hyperion11/Smart-power-supply-khadas-vim/README.md

# Smart-power-supply-khadas-vim
smart power supply for carpc based on khadas vim1 and rtd2662 scaler

IMAGE ALT TEXT HERE (http://www.youtube.com/watch?v=VpjinB8Rm2o)

https://youtu.be/VpjinB8Rm2o
