hyperion11/Smart-power-supply-khadas-vim/powersupply2.png

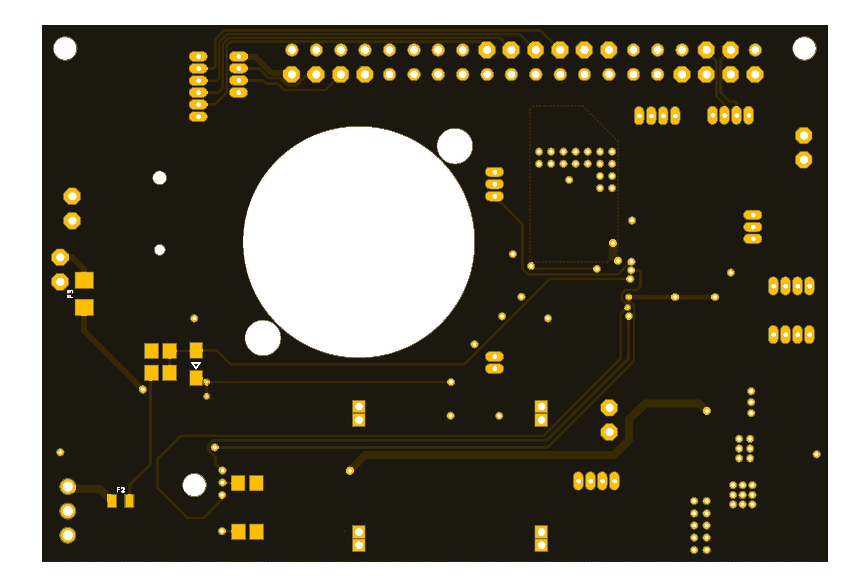
powersupply2.png
