hyperion11/Smart-power-supply-khadas-vim/powersupply.png

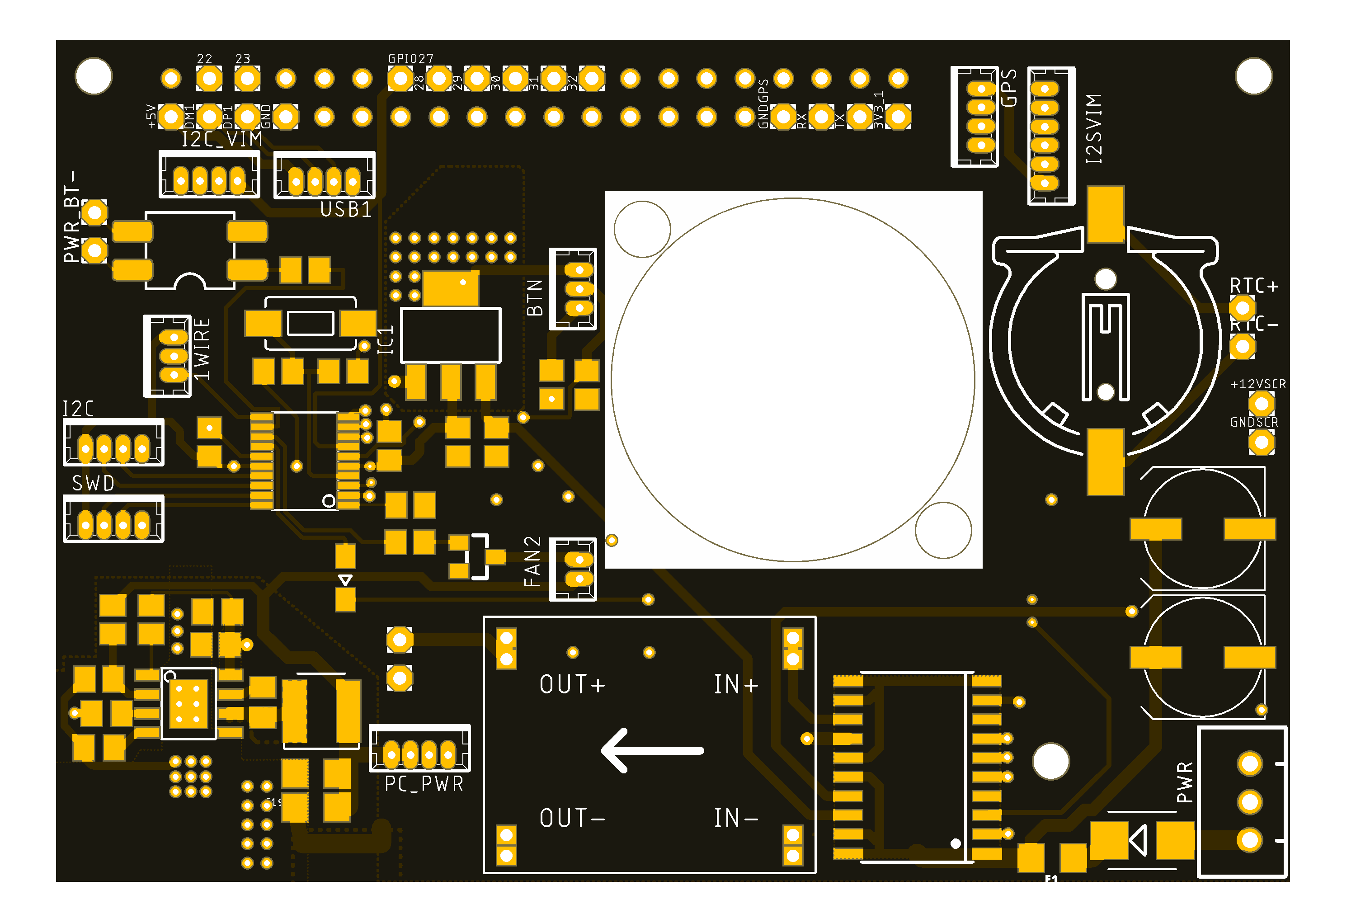
powersupply.png
