hyperion11/Smart-power-supply-khadas-vim/powersupply.xls

Value | Package | MPN | URL
 | 1,6/0,8
 | 1,6/0,8
 | 1,6/0,8
 | 53047-03 | 530470310
 | 1,6/0,8
 | 1,6/0,8
 | 1,6/0,8
 | 1,6/0,8
 | 1,6/0,8
 | 1,6/0,8
 | 1,6/0,8
 | 1,6/0,8
CH291-1220LF | CH291-1220LF
53047-03 | 53047-03 | 530470310
0.1uf | C0805 | CL21B104KBFNNNE
0.1uf | C0805 | CL21B104KBFNNNE
 | UD-8X10_NICHICON
 | UD-8X10_NICHICON
47uF | C1206 | CL31A476MPHNNNE
0.1uf | C0805 | CL21B104KBFNNNE
0.1uf | C0805 | CL21B104KBFNNNE
0.1uf | C0805 | CL21B104KBFNNNE
0.1uF | C0805K | CL21B104KBFNNNE
22uF | C0805 | CL31A226KAHNNNE | https://lcsc.com/product-detail/Multilayer-Ceramic-Capacitors-MLCC-SMD-SMT_SAMSUNG_CL31A226KAHNNNE_22uF-226-10-25V_C12891.html
1uF | C0805K | CL21B105KAFNNNE | https://lcsc.com/product-detail/Multilayer-Ceramic-Capacitors-MLCC-SMD-SMT_Samsung-Electro-Mechanics_CL21B105KAFNNNE_Samsung-Electro-Mechanics-CL21B105KAFNNNE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
8.2nF | C0805K | CL21B822KBANNNC | https://lcsc.com/product-detail/Multilayer-Ceramic-Capacitors-MLCC-SMD-SMT_SAMSUNG_CL21B822KBANNNC_8-2nF-822-10-50V_C170117.html
0.1uF | C0805K | CL21B104KBFNNNE
47uF | C1206 | CL31A476MPHNNNE
 | SMB
 | SOD323-W
 | SOD323-W
 | 1,6/0,8
 | 1,6/0,8
53047-02 | 53047-02 | 53047-0210
 | 1,6/0,8
 | 1,6/0,8
 | 1,6/0,8
 | 1,6/0,8
 | 1,6/0,8
53047-04 | 53047-04 | 53047-0410
i2c | 53047-04 | 53047-0410
53047-04 | 53047-04 | 53047-0410
53047-06 | 53047-06
LM1117MPX-3.3 | SOT223
BTS716G | PG-DSO-20
STM32F030F4P | TSSOP20-I
BCIHP0730-3R3M | VLS4045EX | VLS5045EX-3R3N | https://lcsc.com/product-detail/Power-Inductors_TDK_VLS5045EX-3R3N_TDK-VLS5045EX-3R3N_C307875.html
PC817SMD | DIL04SMD
i2c | 53047-04 | 53047-0410
JST-XH-03-PIN-LONG-PAD | JST-XH-03-PACKAGE-LONG-PAD
 | 1,6/0,8
 | 1,6/0,8
BSS138 | SOT23
150 | R0805
150 | R0805
10k | R0805
2.2k | R0805
10k | R0805
10k | R0805
10K | M0805
10K | M0805
10K | M0805
150 | R0805
22.1K | M0805 | TR0805B22K1P0525Z
124K | M0805 | AR05BTCW1253
10k | M0805
 | 1,6/0,8
 | 1,6/0,8
 | 1,6/0,8
 | TACTILE-SWITCH-1101NE
53047-04 | 53047-04 | 53047-0410
 | 1,6/0,8
MP1584 | DC-BRICK
TPS54428 | PDSO-8 | TPS54428DDAR | https://lcsc.com/product-detail/DC-DC-Converters_Texas-Instruments_TPS54428DDAR_Texas-Instruments-Texas-Instruments-TPS54428DDAR_C138717.html
53047-04 | 53047-04 | 53047-0410
