hyperion11/Smart-power-supply-khadas-vim/powersupply.brd

## EAGLE design powersupply.brd (2020-01-21)

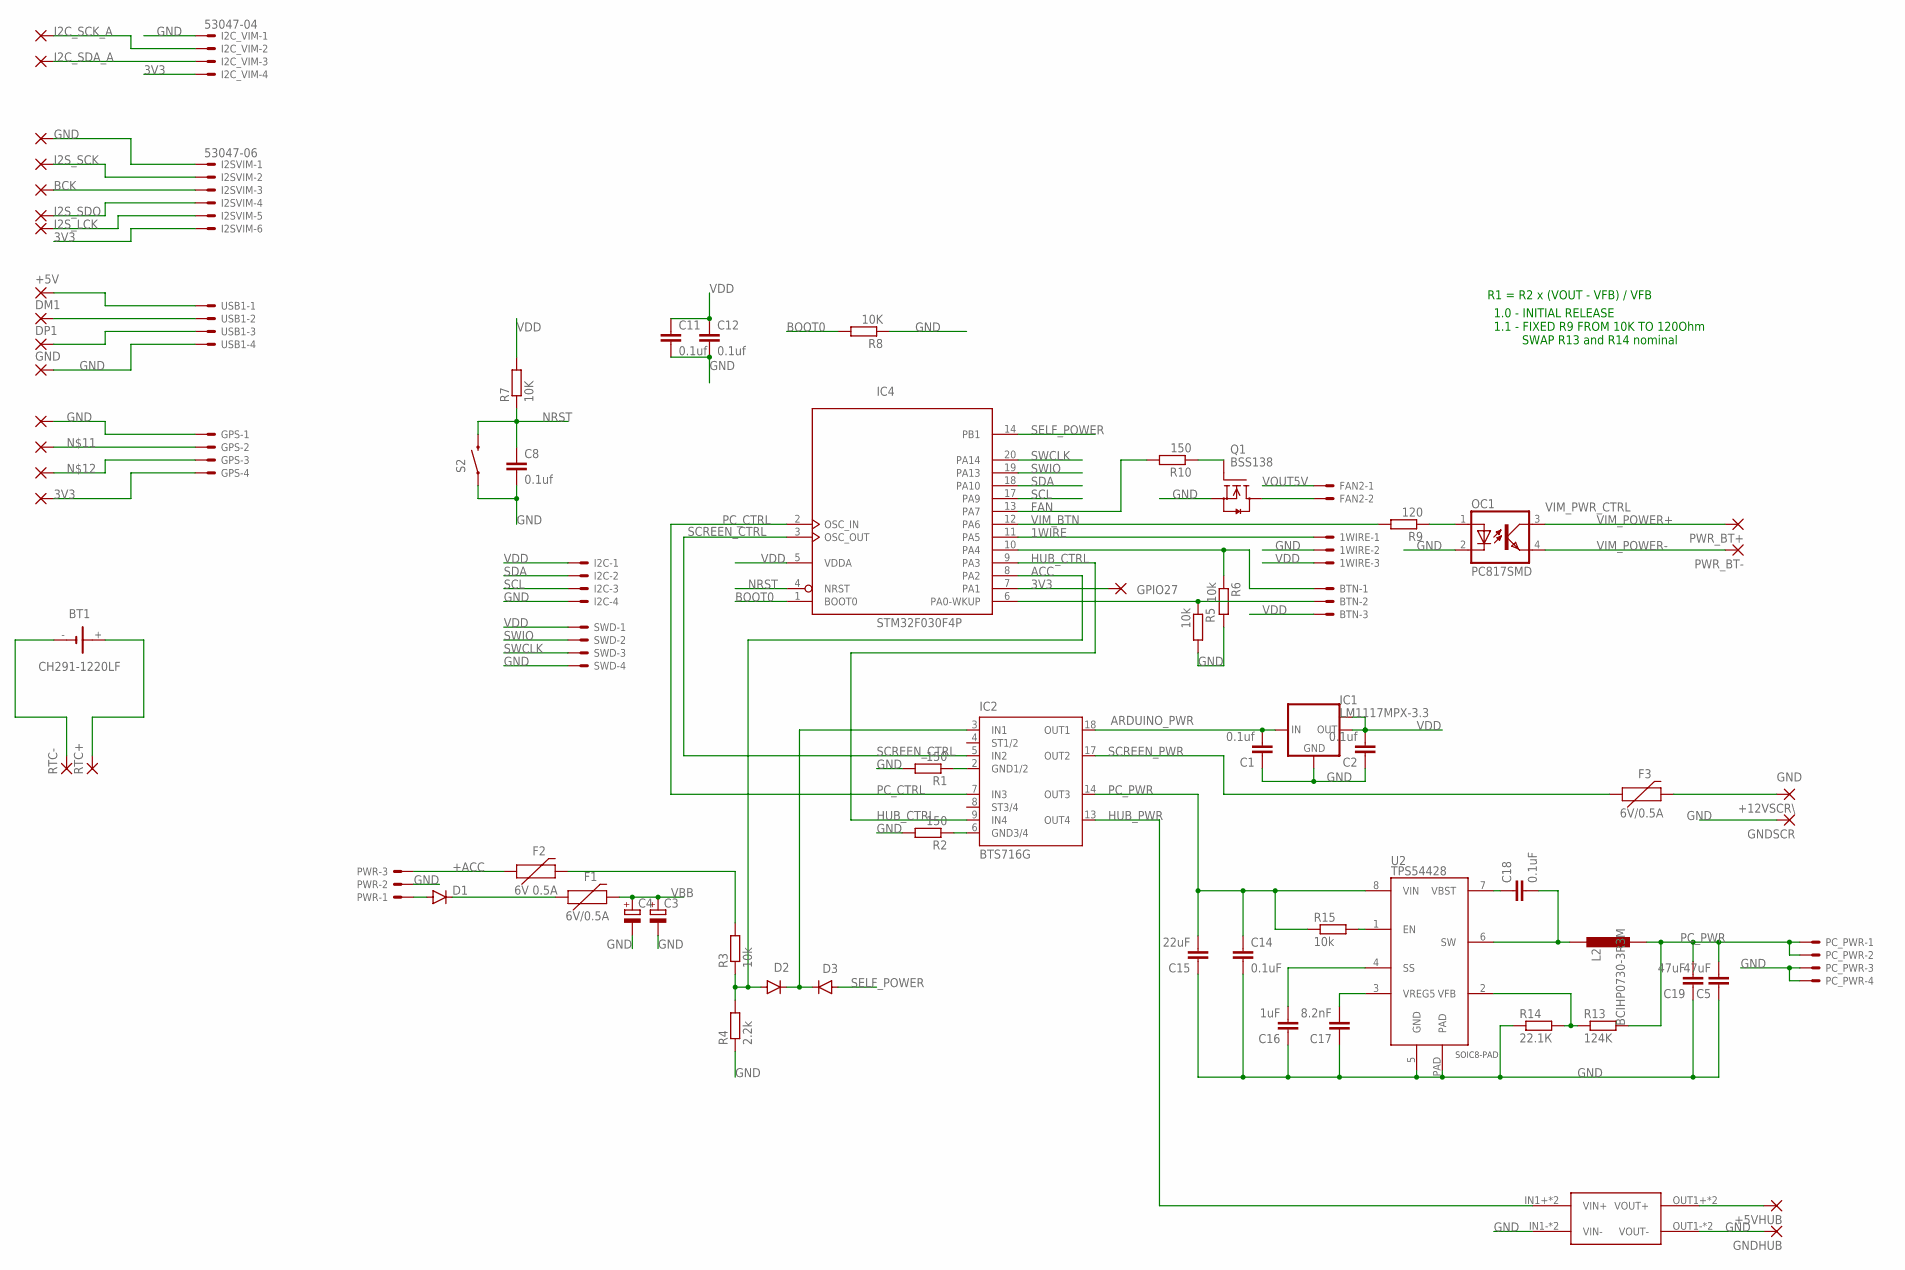
[picture p3: schematic powersupply.sch]

Parts:
1WIRE: 53047-03
3V3_1, 22, 23, 28, 29, 30, 31, 32: 1,6/0,8
+5V, +5VHUB, +12VSCR\: 1,6/0,8
BT1: CH291-1220LF
BTN: 53047-03
C1, C2, C8, C11, C12: 0.1uf; C0805; MPN CL21B104KBFNNNE
C3, C4: CPOL-EUUD-8X10; UD-8X10_NICHICON
C5, C19: 47uF; C1206; MPN CL31A476MPHNNNE
C14, C18: 0.1uF; C0805K; MPN CL21B104KBFNNNE
C15: 22uF; C0805; MPN CL31A226KAHNNNE
C16: 1uF; C0805K; MPN CL21B105KAFNNNE
C17: 8.2nF; C0805K; MPN CL21B822KBANNNC
D1: DIODE-SMB; SMB
D2, D3: DIODE-SOD323-W; SOD323-W
DM1: 1,6/0,8
DP1: 1,6/0,8
F1, F3: 6V/0.5A; 1206
F2: 6V 0.5A; 0805
FAN2: 53047-02
GND: 1,6/0,8
GNDGPS: 1,6/0,8
GNDHUB: 1,6/0,8
GNDSCR: 1,6/0,8
GPIO27: 1,6/0,8
GPS: 53047-04
I2C: i2c; 53047-04
I2C_VIM: 53047-04
I2SVIM: 53047-06
IC1: LM1117MPX-3.3; SOT223; MPN LM1117IMPX-3.3/NOPB
IC2: BTS716G; PG-DSO-20
IC4: STM32F030F4P; TSSOP20-I
L2: BCIHP0730-3R3M; VLS4045EX; MPN VLS5045EX-3R3N
OC1: PC817SMD; DIL04SMD; MPN PC817X2CSP9F
PC_PWR: i2c; 53047-04
PWR: JST-XH-03-PIN-ROUND-PAD; JST-XH-03-PACKAGE-ROUND-PAD
PWR_BT+: 1,6/0,8
PWR_BT-: 1,6/0,8
Q1: BSS138; SOT23
R1, R2, R10: 150; R0805
R3, R5, R6: 10k; R0805
R4: 2.2k; R0805
R7, R8: 10K; M0805
R9: 120; M0805
R13: 124K; M0805; MPN TR0805B22K1P0525Z
R14: 22.1К; M0805; MPN AR05BTCW1253
R15: 10k; M0805
RTC+: 1,6/0,8
RTC-: 1,6/0,8
RX: 1,6/0,8
S2: SWITCH-MOMENTARY-2-SMD-1101NE; TACTILE-SWITCH-1101NE
SWD: 53047-04
TX: 1,6/0,8
U2: TPS54428; PDSO-8
U$1: MP1584; DC-BRICK
USB1: 53047-04

Connections:
1WIRE: 1WIRE.1, IC4.11 (PA5)
3V3: 3V3_1.1, GPIO27.1, GPS.4, I2C_VIM.4, I2SVIM.6, IC4.7 (PA1)
+ACC: F2.2, R3.2
ACC: D2.A, IC4.8 (PA2), R3.1, R4.2
ARDUINO_PWR: C1.2, IC1.3 (IN), IC2.18 (OUT1)
BCK: 30.1, I2SVIM.3
BOOT0: IC4.1 (BOOT0), R8.2
FAN: IC4.13 (PA7), R10.2
GND: 1WIRE.2, 28.1, C1.1, C2.1, C3.-, C4.-, C5.1, C8.2, C11.2, C12.2, C14.2, C15.1, C16.1, C17.1, C19.1, GND.1, GNDGPS.1, GNDHUB.1, GNDSCR.1, GPS.1, I2C.4, I2C_VIM.1, I2SVIM.1, IC1.1 (GND), IC4.15 (GND), OC1.2 (C), PC_PWR.3, PC_PWR.4, PWR.2, Q1.2 (S), R1.2, R2.2, R4.1, R5.2, R6.2, R8.1, R14.1, S2.P$1 (1), SWD.4, U2.5 (GND), U2.PAD, U$1.IN1- (VIN-), U$1.IN2- (VIN-), U$1.OUT1- (VOUT-), U$1.OUT2- (VOUT-), USB1.4
HUB_CTRL: IC2.9 (IN4), IC4.9 (PA3)
HUB_PWR: IC2.13 (OUT4), U$1.IN1+ (VIN+), U$1.IN2+ (VIN+)
I2C_SCK_A: 22.1, I2C_VIM.2
I2C_SDA_A: 23.1, I2C_VIM.3
I2S_LCK: 32.1, I2SVIM.5
I2S_SCK: 29.1, I2SVIM.2
I2S_SDO: 31.1, I2SVIM.4
unnamed: IC2.2 (GND1/2), R1.1
unnamed: +5V.1, USB1.1
unnamed: FAN2.2, Q1.3 (D)
unnamed: D2.C, D3.C, IC2.3 (IN1)
unnamed: IC2.6 (GND3/4), R2.1
unnamed: BTN.1, IC4.10 (PA4), R6.1
unnamed: DM1.1, USB1.2
unnamed: DP1.1, USB1.3
unnamed: Q1.1 (G), R10.1
unnamed: BT1.-, RTC-.1
unnamed: GPS.2, RX.1
unnamed: GPS.3, TX.1
unnamed: BTN.2, IC4.6 (PA0-WKUP), R5.1
unnamed: F2.1, PWR.3
unnamed: BT1.+, RTC+.1
unnamed: D1.A, PWR.1
unnamed: +5VHUB.1, U$1.OUT1+ (VOUT+), U$1.OUT2+ (VOUT+)
unnamed: D1.C, F1.1
unnamed: +12VSCR\.1, F3.2
unnamed: C16.2, U2.4 (SS)
unnamed: C17.2, U2.3 (VREG5)
unnamed: C18.1, U2.7 (VBST)
unnamed: C18.2, L2.1, U2.6 (SW)
unnamed: R13.1, R14.2, U2.2 (VFB)
unnamed: R15.2, U2.1 (EN)
NRST: C8.1, IC4.4 (NRST), R7.1, S2.P$2 (2)
PC_CTRL: IC2.7 (IN3), IC4.2 (OSC_IN)
PC_PWR: C14.1, C15.2, IC2.14 (OUT3), R15.1, U2.8 (VIN)
SCL: I2C.3, IC4.17 (PA9)
SCREEN_CTRL: IC2.5 (IN2), IC4.3 (OSC_OUT)
SCREEN_PWR: F3.1, IC2.17 (OUT2)
SDA: I2C.2, IC4.18 (PA10)
SELF_POWER: D3.A, IC4.14 (PB1)
SWCLK: IC4.20 (PA14), SWD.3
SWIO: IC4.19 (PA13), SWD.2
VBB: C3.+, C4.+, F1.2, IC2.1 (VBB), IC2.10 (VBB), IC2.11 (VBB), IC2.12 (VBB), IC2.15 (VBB), IC2.16 (VBB), IC2.19 (VBB), IC2.20 (VBB)
VDD: 1WIRE.3, BTN.3, C2.2, C11.1, C12.1, I2C.1, IC1.2 (OUT), IC1.TAB (OUT1), IC4.5 (VDDA), IC4.16 (VDD), R7.2, SWD.1
VIM_BTN: IC4.12 (PA6), R9.2
VIM_POWER+: OC1.3 (COL), PWR_BT+.1
VIM_POWER-: OC1.4 (EMIT), PWR_BT-.1
VIM_PWR_CTRL: OC1.1 (A), R9.1
VOUT5V: C5.2, C19.2, FAN2.1, L2.2, PC_PWR.1, PC_PWR.2, R13.2

Notes on the sheet:
R1 = R2 x (VOUT - VFB) / VFB
1.0 - INITIAL RELEASE 1.1 - FIXED R9 FROM 10K TO 120Ohm SWAP R13 and R14 nominal

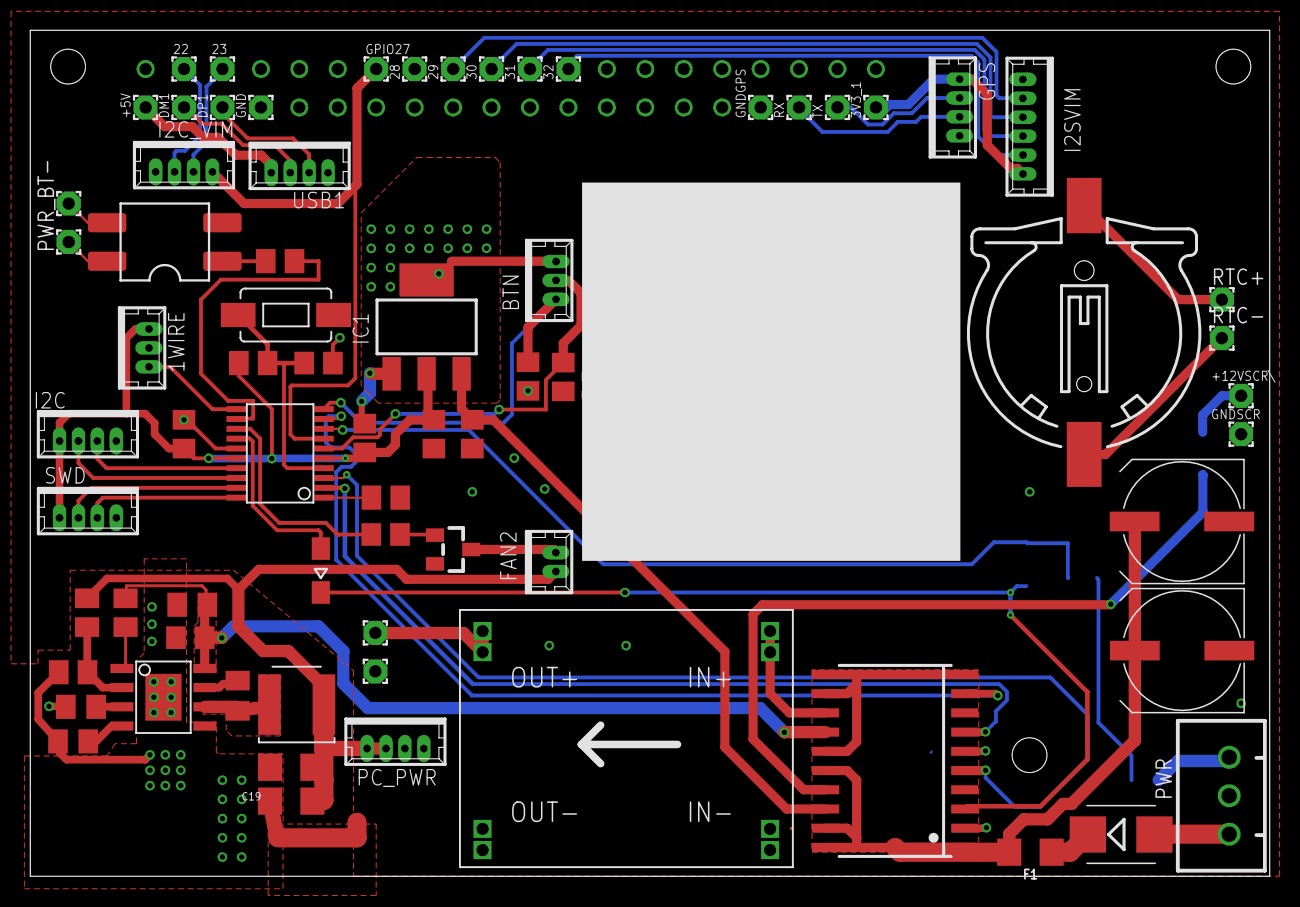
[picture p4: board powersupply.brd from above]

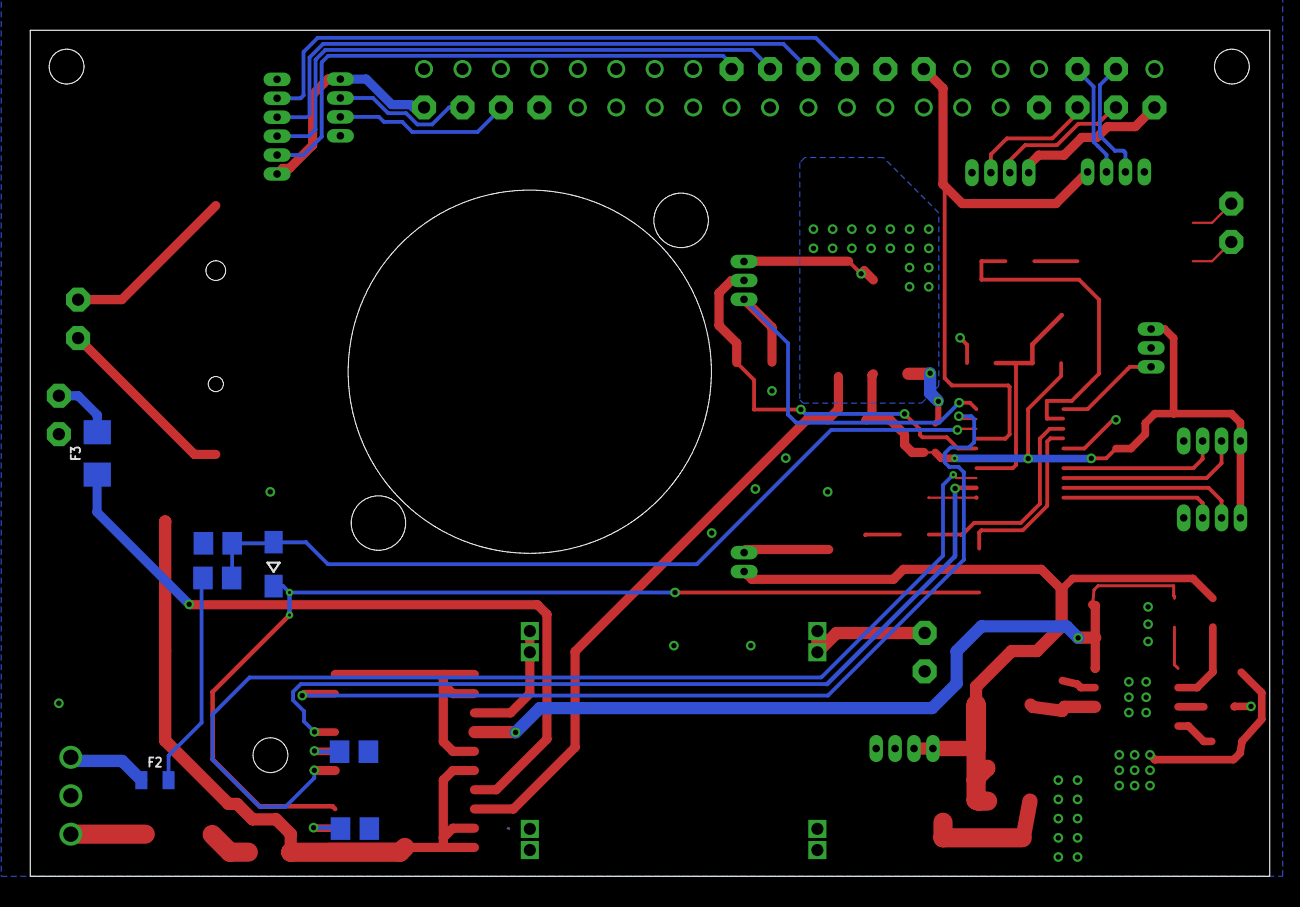
[picture p5: board powersupply.brd from below]

Board: 2 copper layers, 81.9 x 55.9 mm, 78 parts (7 on the bottom side), 58 nets.
