hyperion11/Smart-power-supply-khadas-vim/firmware/Src/main.c

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

/* Includes ------------------------------------------------------------------*/
#include "main.h"

/* USER CODE BEGIN Includes */
#include "arm_math.h"
#include "stdlib.h"
#include <stdbool.h>
#include "ssd1306.h"
#include "fonts.h"
/* USER CODE END Includes */

/* USER CODE BEGIN PTD */
const uint8_t SUSPEND_TIME=10;
const uint8_t SHUTDOWN_TIME=30;
const uint16_t SHUTDOWN_KEYPRESS_TIME=1000; //milliseconds
const uint16_t SHUTDOWN_CHECK_INTERVAL=20; //seconds
const uint8_t VIM_START_DELAY=10; //seconds
/* USER CODE END PTD */

ADC_HandleTypeDef hadc;

/* USER CODE BEGIN PV */


struct screen_str {
	bool enabled;
};

struct acc_str {
	bool enabled;
	bool low;
	uint16_t voltage;
	uint32_t time_to_suspend;
	uint32_t time_to_shutdown;
};

struct vim_str {
	bool enabled;
	bool sleep;
	bool voltage;
	uint8_t shutdown_count;
};

struct itps_str {
	bool enabled;
	uint32_t time_to_action;
};

struct hub_str {
	bool enabled;
};
struct screen_str SCREEN;
struct vim_str VIM;
struct itps_str ITPS;
struct hub_str HUB;
struct acc_str ACC;

uint32_t now, next;
float t;
/* USER CODE END PV */

void SystemClock_Config(void);
static void MX_GPIO_Init(void);
static void MX_ADC_Init(void);
/* USER CODE BEGIN 0 */
uint16_t readADC() {
	uint16_t adc = 0;
	HAL_ADC_Start(&hadc);
	if (HAL_ADC_PollForConversion(&hadc, 100) != HAL_OK) {
		Error_Handler();
	} else {
		adc = HAL_ADC_GetValue(&hadc);
	}
	HAL_ADC_Stop(&hadc);
	return adc;
}

bool checkVIM() {
	VIM.voltage = HAL_GPIO_ReadPin(GPIOA, GPIO_PIN_1);
	if (VIM.voltage == true)
		return 1;
	else
		return 0;
}

void EnableScreen(bool force) {
	if (SCREEN.enabled == false) {
		HAL_GPIO_WritePin(SCREEN_PWR_GPIO_Port, SCREEN_PWR_Pin, GPIO_PIN_SET);
		SCREEN.enabled = true;
	}
	if (force) {
		HAL_GPIO_WritePin(SCREEN_PWR_GPIO_Port, SCREEN_PWR_Pin, GPIO_PIN_SET);
		SCREEN.enabled = true;
	}
}

void EnableVIM(bool force) {
	if (VIM.enabled == false) {
		HAL_GPIO_WritePin(FAN_GPIO_Port, FAN_Pin, GPIO_PIN_SET);
		HAL_GPIO_WritePin(PC_PWR_GPIO_Port, PC_PWR_Pin, GPIO_PIN_SET);
		VIM.enabled = true;
	}
	if (force) {
		HAL_GPIO_WritePin(PC_PWR_GPIO_Port, PC_PWR_Pin, GPIO_PIN_SET);
		HAL_GPIO_WritePin(FAN_GPIO_Port, FAN_Pin, GPIO_PIN_SET);
		VIM.enabled = true;
	}
}

void EnableHUB(bool force) {
	if (HUB.enabled == false) {
		HAL_GPIO_WritePin(HUB_PWR_GPIO_Port, HUB_PWR_Pin, GPIO_PIN_SET);
		HUB.enabled = true;
	}
	if (force) {
		HAL_GPIO_WritePin(HUB_PWR_GPIO_Port, HUB_PWR_Pin, GPIO_PIN_SET);
		HUB.enabled = true;
	}
}

void DisableScreen(bool force) {
	if (SCREEN.enabled == true) {
		HAL_GPIO_WritePin(SCREEN_PWR_GPIO_Port, SCREEN_PWR_Pin, GPIO_PIN_RESET);
		SCREEN.enabled = false;
	}
	if (force) {
		HAL_GPIO_WritePin(SCREEN_PWR_GPIO_Port, SCREEN_PWR_Pin, GPIO_PIN_RESET);
		SCREEN.enabled = false;
	}
}

void DisableVIM(bool force) {
	if (VIM.enabled == true) {
		HAL_GPIO_WritePin(FAN_GPIO_Port, FAN_Pin, GPIO_PIN_RESET);
		HAL_GPIO_WritePin(PC_PWR_GPIO_Port, PC_PWR_Pin, GPIO_PIN_RESET);
		VIM.enabled = false;
		VIM.sleep = false;
	}
	if (force) {
		HAL_GPIO_WritePin(FAN_GPIO_Port, FAN_Pin, GPIO_PIN_RESET);
		HAL_GPIO_WritePin(PC_PWR_GPIO_Port, PC_PWR_Pin, GPIO_PIN_RESET);
		VIM.enabled = false;
		VIM.sleep = false;
	}
}

void DisableHUB(bool force) {
	if (HUB.enabled == true) {
		HAL_GPIO_WritePin(HUB_PWR_GPIO_Port, HUB_PWR_Pin, GPIO_PIN_RESET);
		HUB.enabled = false;
	}
	if (force) {
		HAL_GPIO_WritePin(HUB_PWR_GPIO_Port, HUB_PWR_Pin, GPIO_PIN_RESET);
		HUB.enabled = false;
	}
}

void DisableITPS() {
	HAL_GPIO_WritePin(SELF_PWR_GPIO_Port, SELF_PWR_Pin, GPIO_PIN_RESET);
	ITPS.enabled = false;
}

void SuspendVIM() {
	if (VIM.sleep == false) {
		HAL_GPIO_WritePin(VIM_BTN_GPIO_Port, VIM_BTN_Pin, GPIO_PIN_SET);
		HAL_Delay(100);
		HAL_GPIO_WritePin(VIM_BTN_GPIO_Port, VIM_BTN_Pin, GPIO_PIN_RESET);
		HAL_GPIO_WritePin(FAN_GPIO_Port, FAN_Pin, GPIO_PIN_RESET);
		VIM.sleep = true;
	}
}

void ShutdownVIM() {
	HAL_GPIO_WritePin(VIM_BTN_GPIO_Port, VIM_BTN_Pin, GPIO_PIN_SET);
	HAL_Delay(SHUTDOWN_KEYPRESS_TIME);
	HAL_GPIO_WritePin(VIM_BTN_GPIO_Port, VIM_BTN_Pin, GPIO_PIN_RESET);
}

void ResumeVIM() {
	if (VIM.sleep == true) {
		HAL_GPIO_WritePin(VIM_BTN_GPIO_Port, VIM_BTN_Pin, GPIO_PIN_SET);
		HAL_Delay(500);
		HAL_GPIO_WritePin(VIM_BTN_GPIO_Port, VIM_BTN_Pin, GPIO_PIN_RESET);
		VIM.sleep = false;
		HAL_GPIO_WritePin(FAN_GPIO_Port, FAN_Pin, GPIO_PIN_SET);
	}
}

long map(long x, long in_min, long in_max, long out_min, long out_max) {
	return (x - in_min) * (out_max - out_min) / (in_max - in_min) + out_min;
}

/* USER CODE END 0 */

/**
  * @brief  The application entry point.
  * @retval int
  */
int main(void)
{
  /* MCU Configuration--------------------------------------------------------*/

  /* Reset of all peripherals, Initializes the Flash interface and the Systick. */
  HAL_Init();

  /* Configure the system clock */
  SystemClock_Config();

  /* Initialize all configured peripherals */
  MX_GPIO_Init();
  MX_ADC_Init();
  /* USER CODE BEGIN 2 */
  	  RCC->APB2ENR |= RCC_APB2ENR_TIM16EN; //тактируем таймер
  	  TIM16->CR1 |= TIM_CR1_CEN; //включаем
	HAL_ADC_Stop(&hadc);
	HAL_ADCEx_Calibration_Start(&hadc);
  /* USER CODE END 2 */

  /* Infinite loop */
  /* USER CODE BEGIN WHILE */
	VIM.shutdown_count=0;
	HAL_GPIO_WritePin(SELF_PWR_GPIO_Port, SELF_PWR_Pin, GPIO_PIN_SET);
	ITPS.enabled = true;
	HUB.enabled = false;
	SCREEN.enabled = false;
	VIM.enabled = false;
	VIM.sleep = false;
	HAL_Delay(2000);
	while (readADC() < 2814) {
	}
	EnableScreen(false);
	HAL_Delay(VIM_START_DELAY*1000);
	if (readADC() >2814)
		EnableVIM(false);
	else
		DisableITPS();		//disable WHOLE Supply voltage
	HAL_Delay(2000);
	EnableHUB(false);
	while (1) {
		ACC.voltage = readADC();
		//every 100ms
		if (HAL_GetTick() >= next) {
			ACC.voltage = readADC();
			checkVIM();
			if (ACC.voltage < 3169 && ACC.time_to_suspend == 0 && ACC.time_to_shutdown == 0) //ACC Voltage below 11v
			{
				if (VIM.enabled==false)
				{
					DisableVIM(false);	//disable VIM Supply voltage
					HAL_Delay(10);
					DisableHUB(false);	//disable HUB Supply voltage
					HAL_Delay(10);
					DisableScreen(false);
					HAL_Delay(100);	//disable SCREEN Supply voltage
					DisableITPS();		//disable WHOLE Supply voltage
				}
				else
				{
					ACC.enabled = false;
					ACC.low = true;
					ACC.time_to_suspend = HAL_GetTick() + SUSPEND_TIME * 1000; //10 seconds to suspend
					ACC.time_to_shutdown = ACC.time_to_suspend + SHUTDOWN_TIME * 1000; //5 hours to shutdown
				}
			}
			if (ACC.voltage > 3169) //if ACC voltage > 12.2V! cancel suspend an resume carpc
					{
				ACC.enabled = true;
				ACC.low = false;
				ACC.time_to_suspend = 0; //
				ACC.time_to_shutdown = 0; //
			}
			next = HAL_GetTick() + 100;
		}
		if (HAL_GetTick() >= ACC.time_to_suspend && ACC.time_to_suspend != 0) {
			SuspendVIM(false);
			HAL_Delay(5000); // 5 seconds to suspend
			DisableHUB(false);
			HAL_Delay(2000);
			DisableScreen(false);
		}
		if (HAL_GetTick() >= ACC.time_to_shutdown && ACC.time_to_shutdown != 0) {
			EnableScreen(false);
			HAL_Delay(2 * 1000);
			ShutdownVIM();  //VIM starts to resume from sleep
			HAL_Delay(5 * 1000); //5 seconds to resuming
			while (checkVIM()) { // checking voltage on GPIO27 VIM's pin.
				ShutdownVIM();	// if still HIGH try shutdown again
				HAL_Delay(SHUTDOWN_CHECK_INTERVAL * 1000); //~20 seconds to shutdown OS on vim
				VIM.shutdown_count++;	//counter of shutdown tries
				if (VIM.shutdown_count>5) // maximum 4 retries
				{
					DisableVIM(false); 		//and hard off
					break;
				}
			}
			HAL_Delay(2 * 1000);
			DisableVIM(false);	//disable VIM Supply voltage
			HAL_Delay(2 * 1000);
			DisableHUB(false);	//disable HUB Supply voltage
			HAL_Delay(1000);
			DisableScreen(false);
			HAL_Delay(1000);	//disable SCREEN Supply voltage
			DisableITPS();		//disable WHOLE Supply voltage
		}
		if (ACC.time_to_suspend == 0 && VIM.sleep == true) {
			EnableScreen(false);
			HAL_Delay(2 * 1000);
			ResumeVIM(false);
			HAL_Delay(4 * 1000); //4 seconds to resume
			EnableHUB(false);
		}
		if (ACC.time_to_shutdown == 0 && VIM.enabled == false) {
			EnableScreen(false);
			HAL_Delay(2 * 1000);
			EnableVIM(false);
			HAL_Delay(2 * 1000);
			EnableHUB(false);
		}

    /* USER CODE END WHILE */

    /* USER CODE BEGIN 3 */
	}
  /* USER CODE END 3 */
}

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
