hyperion11/Smart-power-supply-khadas-vim/firmware/Inc/main.h

#define PC_PWR_Pin GPIO_PIN_0
#define PC_PWR_GPIO_Port GPIOF
#define SCREEN_PWR_Pin GPIO_PIN_1
#define SCREEN_PWR_GPIO_Port GPIOF
#define BTN2_Pin GPIO_PIN_0
#define BTN2_GPIO_Port GPIOA
#define VIM_IN_Pin GPIO_PIN_1
#define VIM_IN_GPIO_Port GPIOA
#define HUB_PWR_Pin GPIO_PIN_3
#define HUB_PWR_GPIO_Port GPIOA
#define BTN1_Pin GPIO_PIN_4
#define BTN1_GPIO_Port GPIOA
#define VIM_BTN_Pin GPIO_PIN_6
#define VIM_BTN_GPIO_Port GPIOA
#define FAN_Pin GPIO_PIN_7
#define FAN_GPIO_Port GPIOA
#define SELF_PWR_Pin GPIO_PIN_1
#define SELF_PWR_GPIO_Port GPIOB
