hyperion11/Smart-power-supply-khadas-vim/(commit log)

2019-08-02 init commit
    [powersupply.brd, powersupply.sch]
2020-01-21 фиксы схемы
    R9 FROM 10K TO 120Ohm
    SWAP R13 and R14 nominal
    [powersupply.brd, powersupply.sch]
2020-01-21 комменты+таймеры
2020-03-24 pre-pre2
    Фикс просыпания (не включался кулер)
    Почти все готово для тестирования
